LAD-Automotive-Innovations/UA4EFI_ECU/DC_MOTOR_0.1.kicad_sch

## KiCad design DC_MOTOR_0.1.kicad_sch (2025-12-19, last stored version)

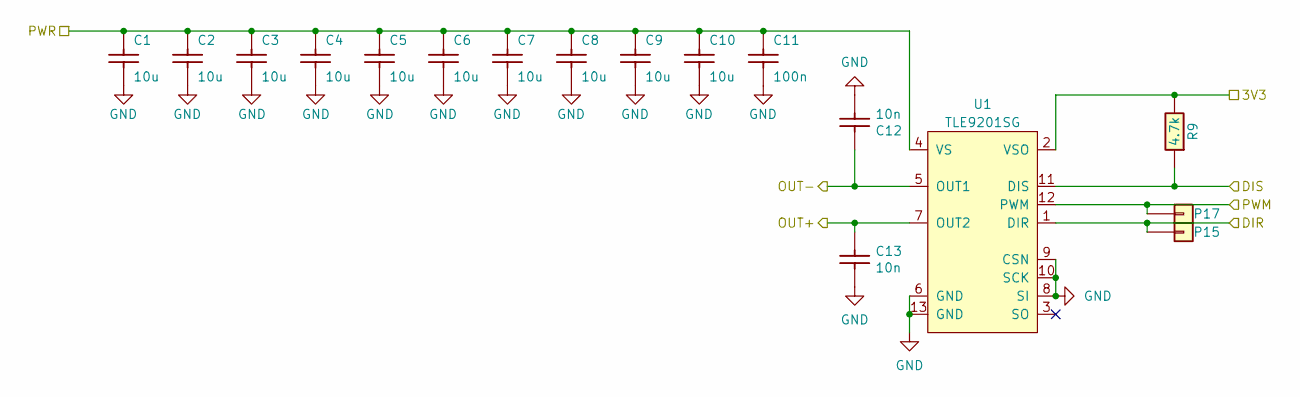
[picture p1: schematic DC_MOTOR_0.1.kicad_sch]

Parts:
C1, C2, C3, C4, C5, C6, C7, C8, C9, C10: 10u; C0805; LCSC C15850
C11: 100n; C0603; LCSC C14663
C12, C13: 10n; C0603; LCSC C57112
P15, P17: Pad; PAD-TH
R9: 4.7k; R0603; LCSC C23162
U1: TLE9201SG; Infineon_PG-DSO-12-11; LCSC C112633

Connections:
3V3: R9.2, U1.2 (VSO)
DIR: P15.1, U1.1 (DIR)
DIS: R9.1, U1.11 (DIS)
GND: C1.1, C2.1, C3.1, C4.1, C5.1, C6.1, C7.1, C8.1, C9.1, C10.1, C11.1, C12.1, C13.1, U1.6 (GND), U1.8 (SI), U1.9 (CSN), U1.10 (SCK), U1.13 (GND)
OUT+: C13.2, U1.7 (OUT2)
OUT-: C12.2, U1.5 (OUT1)
PWM: P17.1, U1.12 (PWM)
PWR: C1.2, C2.2, C3.2, C4.2, C5.2, C6.2, C7.2, C8.2, C9.2, C10.2, C11.2, U1.4 (VS)
