LAD-Automotive-Innovations/UA4EFI_ECU/IGN6.kicad_sch

## KiCad design IGN6.kicad_sch (2025-12-19, last stored version)

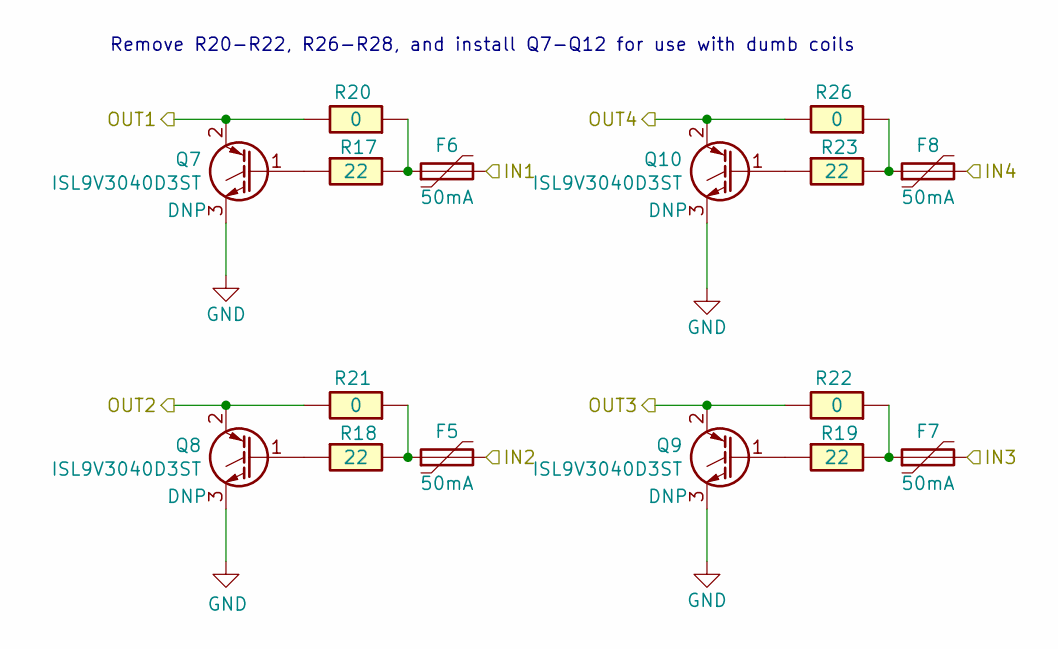
[picture p2: schematic IGN6.kicad_sch]

Parts:
F5, F6, F7, F8: 50mA; Fuse_0603_1608Metric; LCSC C369141
Q7, Q8, Q9, Q10: ISL9V3040D3ST; TO-252-2
R17, R18, R19, R23: 22; R0603; LCSC C23345
R20, R21, R22, R26: 0; R_2512_6332Metric; LCSC C25469

Connections:
GND: Q7.3 (E), Q8.3 (E), Q9.3 (E), Q10.3 (E)
IN1: F6.2
IN2: F5.2
IN3: F7.2
IN4: F8.2
unnamed: F5.1, R18.2, R21.1
unnamed: F6.1, R17.2, R20.1
unnamed: F7.1, R19.2, R22.1
unnamed: F8.1, R23.2, R26.1
unnamed: Q7.1 (G), R17.1
unnamed: Q8.1 (G), R18.1
unnamed: Q9.1 (G), R19.1
unnamed: Q10.1 (G), R23.1
OUT1: Q7.2 (C), R20.2
OUT2: Q8.2 (C), R21.2
OUT3: Q9.2 (C), R22.2
OUT4: Q10.2 (C), R26.2

Notes on the sheet:
Remove R20-R22, R26-R28, and install Q7-Q12 for use with dumb coils
