LAD-Automotive-Innovations/UA4EFI_ECU/INJ6.kicad_sch

## KiCad design INJ6.kicad_sch (2025-12-19, last stored version)

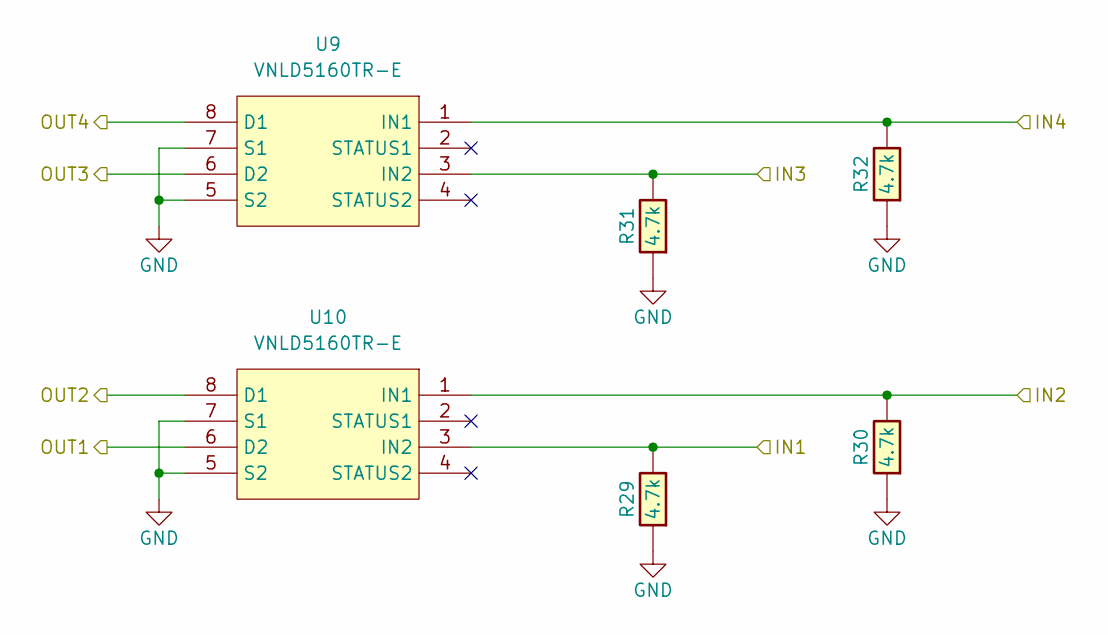
[picture p3: schematic INJ6.kicad_sch]

Parts:
R29, R30, R31, R32: 4.7k; R0603; LCSC C23162
U9, U10: VNLD5160TR-E; SOIC-8_3.9x4.9mm_P1.27mm; LCSC C377942

Connections:
GND: R29.1, R30.1, R31.1, R32.1, U9.5 (S2), U9.7 (S1), U10.5 (S2), U10.7 (S1)
IN1: R29.2, U10.3 (IN2)
IN2: R30.2, U10.1 (IN1)
IN3: R31.2, U9.3 (IN2)
IN4: R32.2, U9.1 (IN1)
OUT1: U10.6 (D2)
OUT2: U10.8 (D1)
OUT3: U9.6 (D2)
OUT4: U9.8 (D1)
