LAD-Automotive-Innovations/UA4EFI_ECU/LS4.kicad_sch

## KiCad design LS4.kicad_sch (2025-12-19, last stored version)

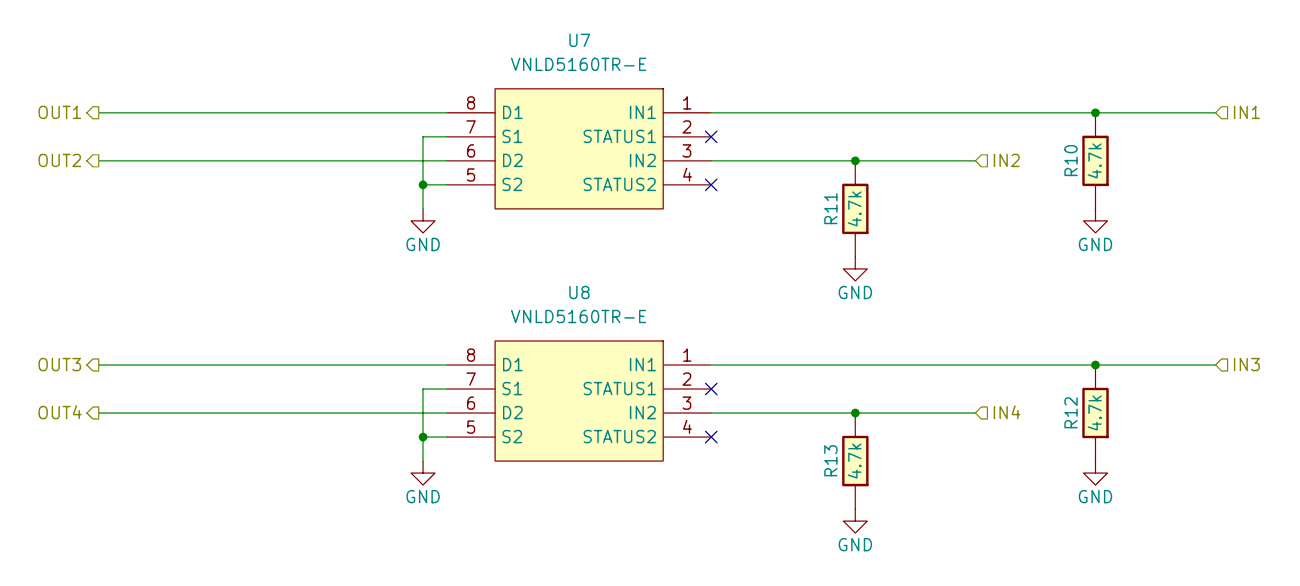
[picture p4: schematic LS4.kicad_sch]

Parts:
R10, R11, R12, R13: 4.7k; R0603; LCSC C23162
U7, U8: VNLD5160TR-E; SOIC-8_3.9x4.9mm_P1.27mm; LCSC C377942

Connections:
GND: R10.1, R11.1, R12.1, R13.1, U7.5 (S2), U7.7 (S1), U8.5 (S2), U8.7 (S1)
IN1: R10.2, U7.1 (IN1)
IN2: R11.2, U7.3 (IN2)
IN3: R12.2, U8.1 (IN1)
IN4: R13.2, U8.3 (IN2)
OUT1: U7.8 (D1)
OUT2: U7.6 (D2)
OUT3: U8.8 (D1)
OUT4: U8.6 (D2)
