LAD-Automotive-Innovations/UA4EFI_ECU/LS_HOT.kicad_sch

## KiCad design LS_HOT.kicad_sch (2025-12-19, last stored version)

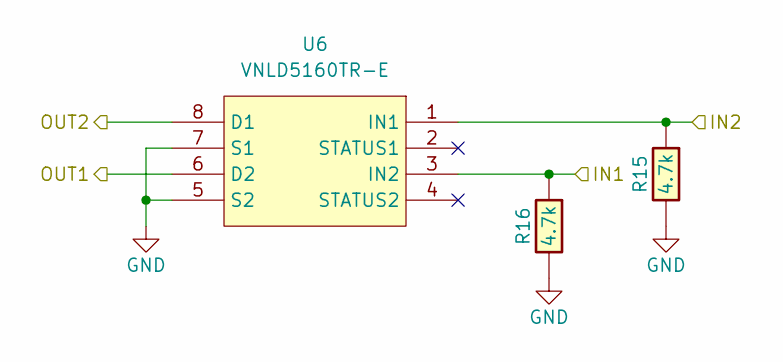
[picture p5: schematic LS_HOT.kicad_sch]

Parts:
R15, R16: 4.7k; R0603; LCSC C23162
U6: VNLD5160TR-E; SOIC-8_3.9x4.9mm_P1.27mm; LCSC C377942

Connections:
GND: R15.2, R16.2, U6.5 (S2), U6.7 (S1)
IN1: R16.1, U6.3 (IN2)
IN2: R15.1, U6.1 (IN1)
OUT1: U6.6 (D2)
OUT2: U6.8 (D1)
