LAD-Automotive-Innovations/UA4EFI_ECU/MAP.kicad_sch

## KiCad design MAP.kicad_sch (2025-12-19, last stored version)

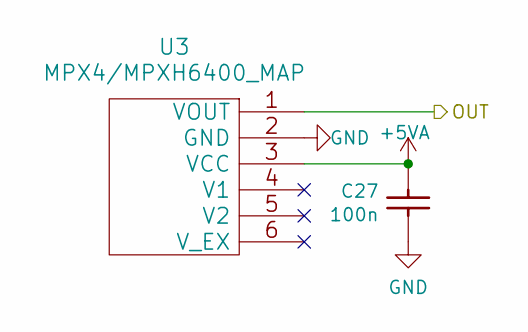
[picture p6: schematic MAP.kicad_sch]

Parts:
C27: 100n; C0603; LCSC C14663
U3: MPX4/MPXH6400_MAP; MPX-4_MAP

Connections:
+5VA: C27.2, U3.3 (VCC)
GND: C27.1, U3.2 (GND)
OUT: U3.1 (VOUT)
