LAD-Automotive-Innovations/UA4EFI_ECU/UA4EFI.kicad_sch

## KiCad design UA4EFI.kicad_sch (2025-12-19, last stored version)

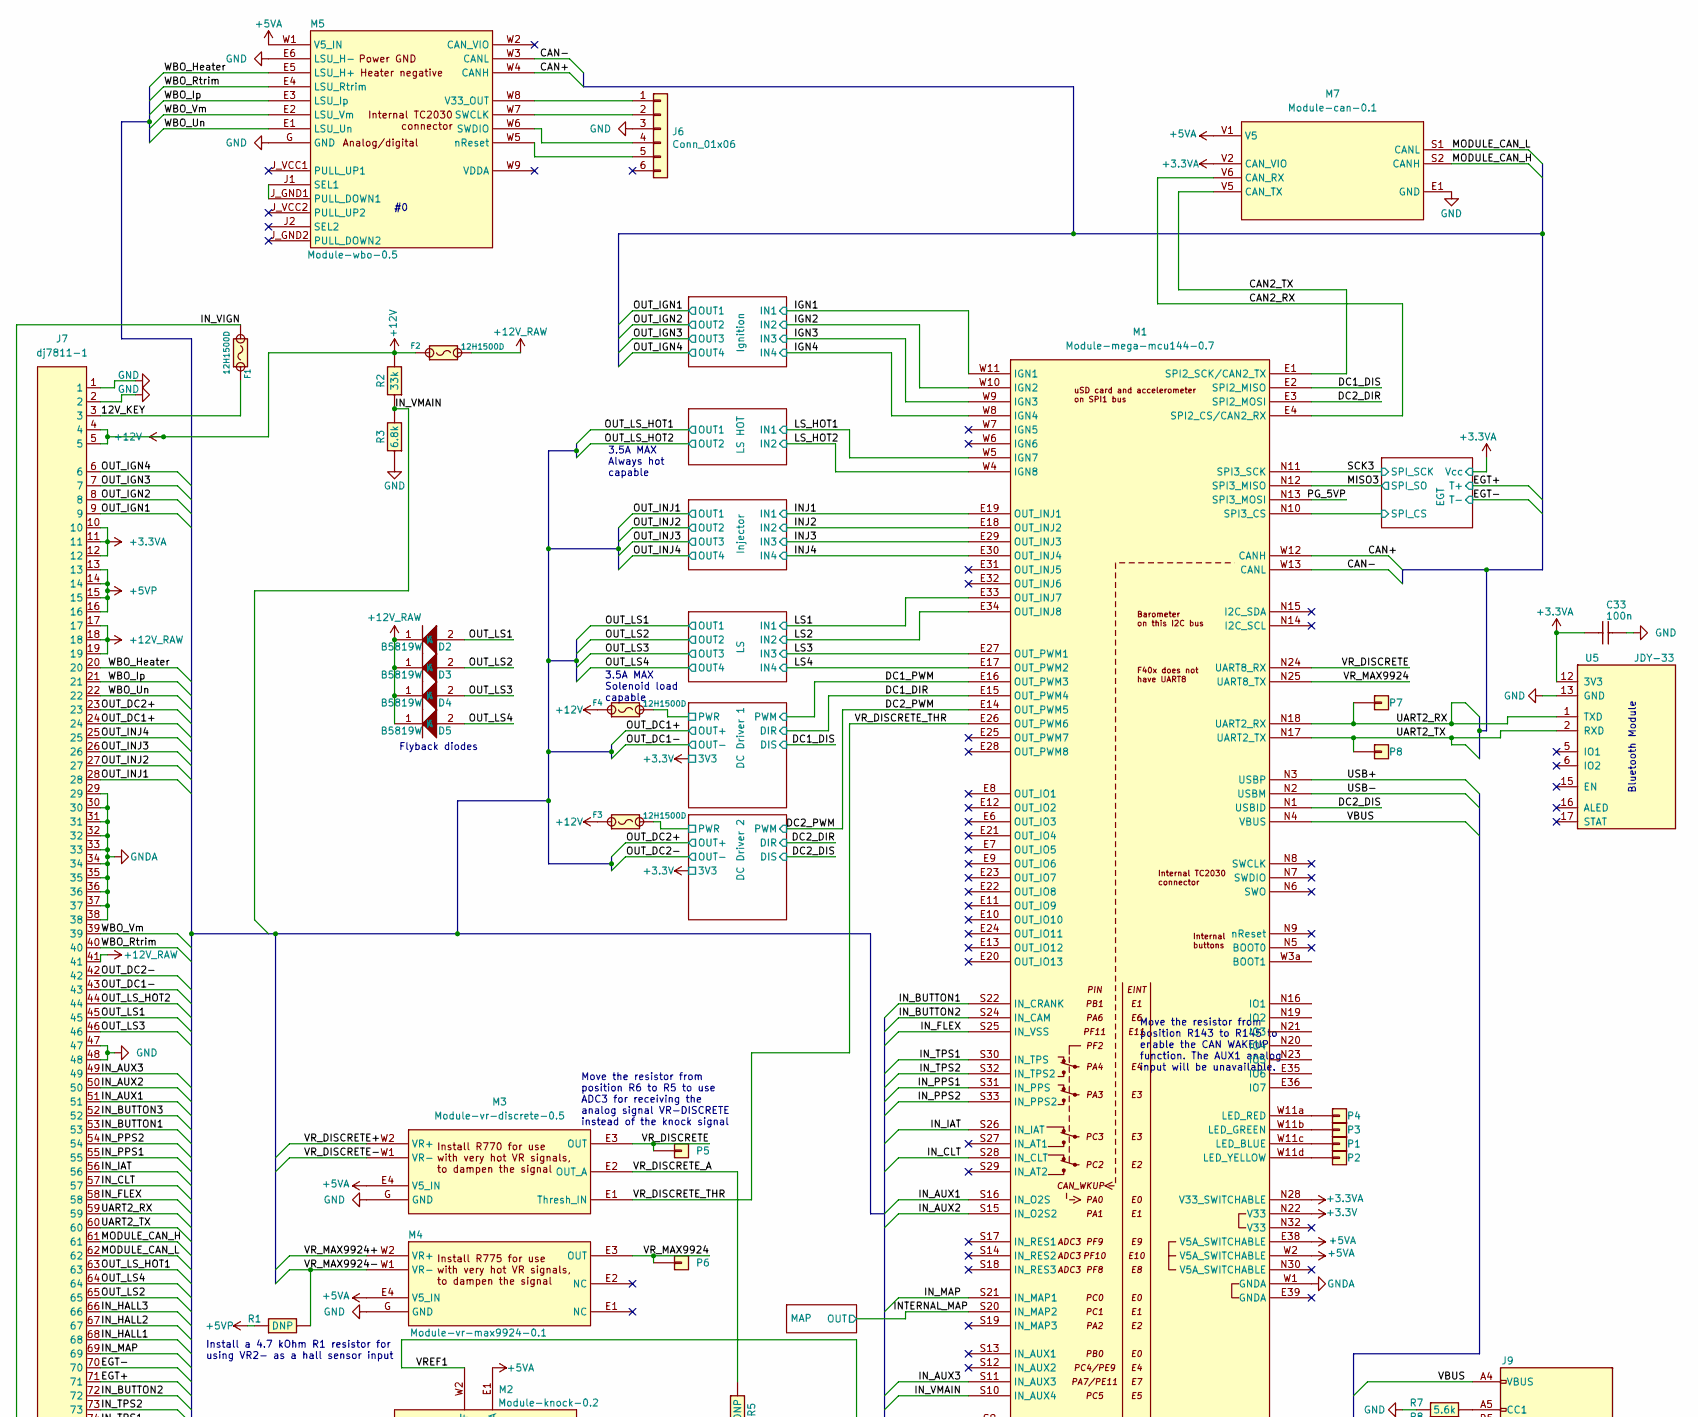
[picture p7: schematic UA4EFI.kicad_sch, part in row 1, column 1]

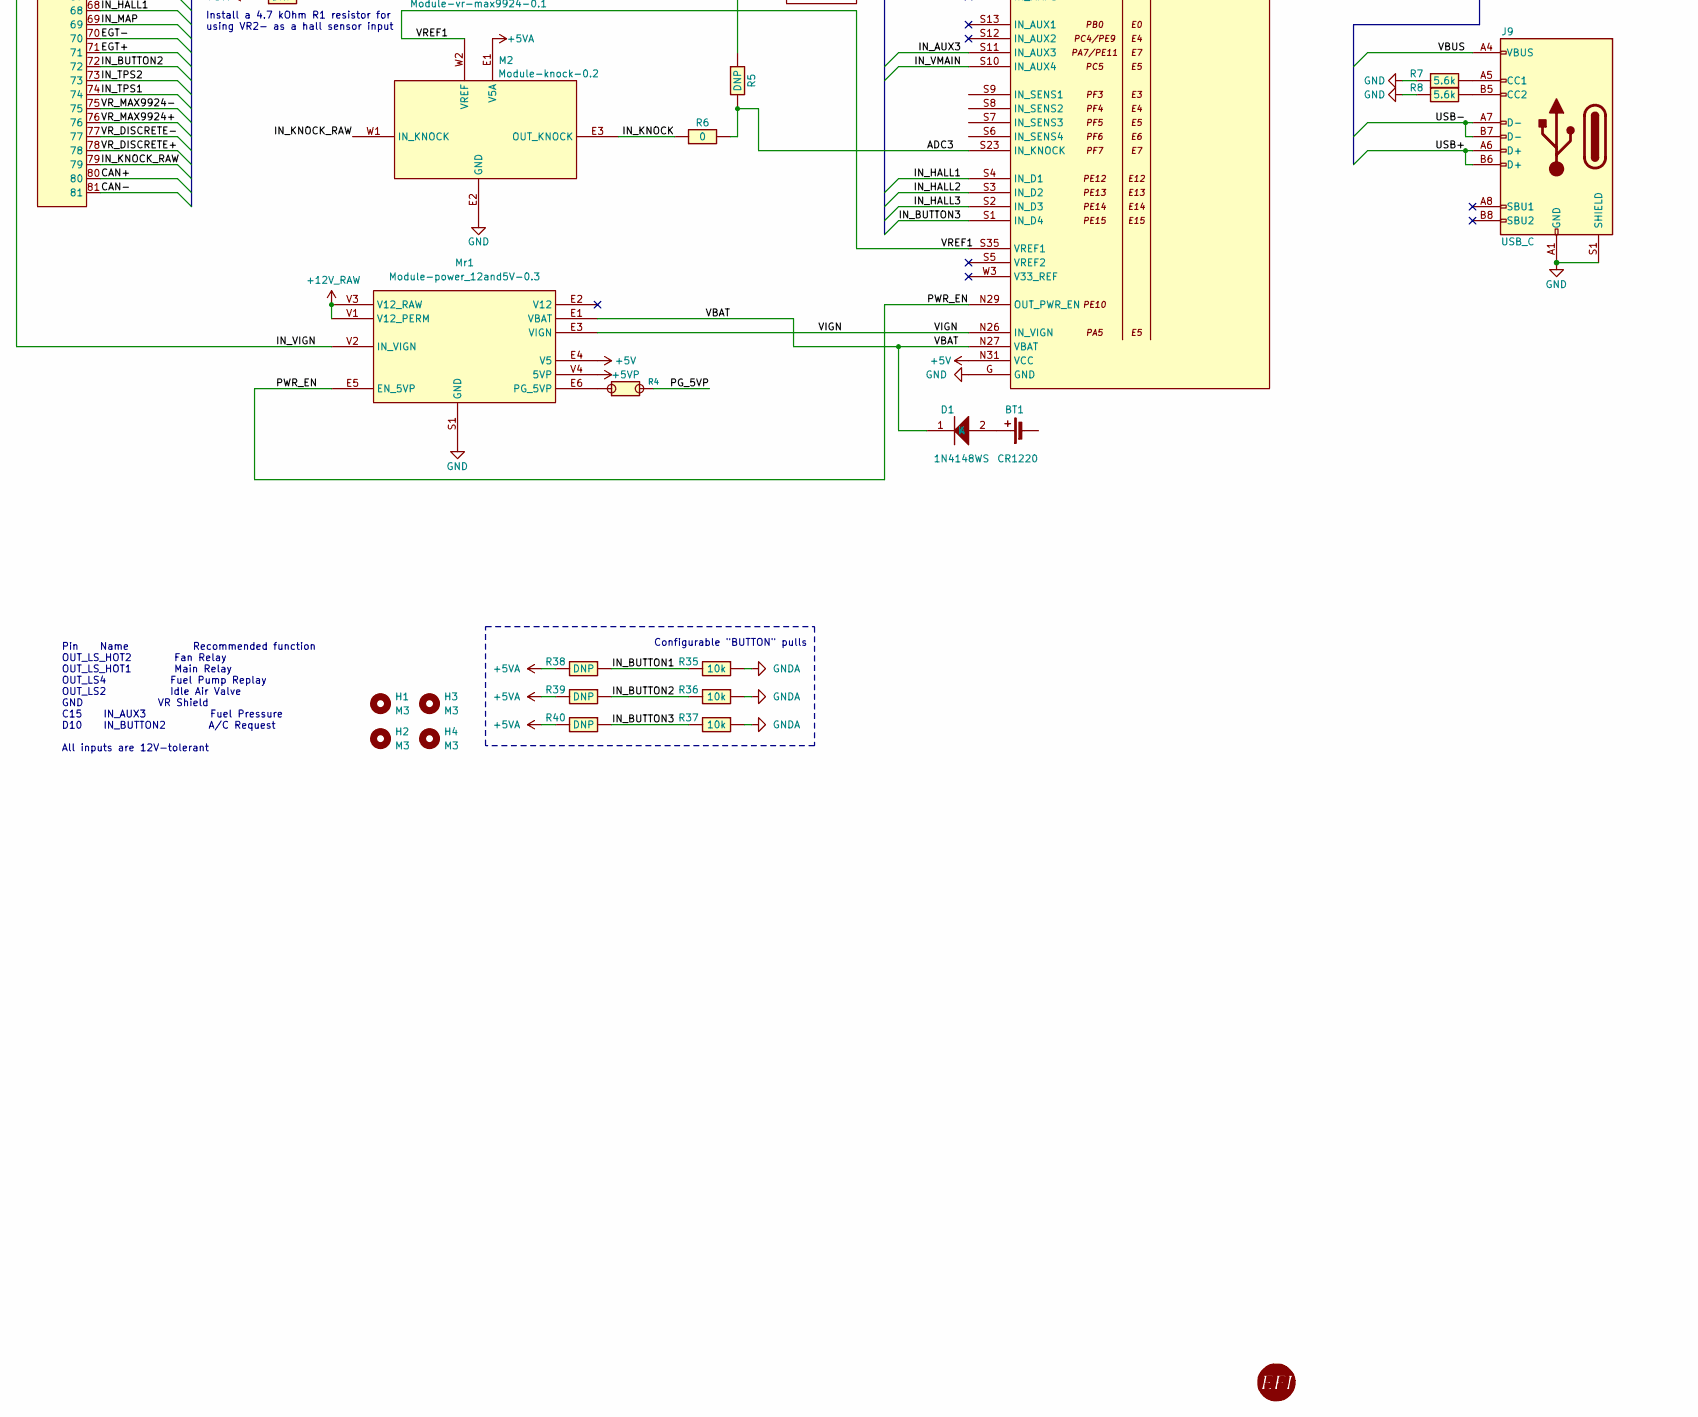
[picture p8: schematic UA4EFI.kicad_sch, part in row 2, column 1]

Parts:
BT1: CR1220; CR1220-2; LCSC C70381
C33: 100n; C0603; LCSC C14663
D1: 1N4148WS; SOD-323; LCSC C2128
D2, D3, D4, D5: B5819W; SOD-123; LCSC C8598
F1, F2, F3, F4: 12H1500D; PAD-1206-PAD; LCSC C182446
G1: RUSEFI_LOGO; rusefi_logo
H1, H2, H3, H4: M3; MountingHole_3.2mm_M3_Pad_Via
J6: Conn_01x06; PinHeader_1x06_P2.54mm_Vertical; LCSC C37208
J7: dj7811-1; LCSC C9900074225
J9: USB_C; LCSC C2927038
M1: Module-mega-mcu144-0.7; mega-mcu144
M2: Module-knock-0.2; knock
M3: Module-vr-discrete-0.5; vr-discrete
M4: Module-vr-max9924-0.1; vr-max9924
M5: Module-wbo-0.5; wbo
M7: Module-can-0.1; can
Mr1: Module-power_12and5V-0.3; power_12and5V
P1, P2, P3, P4, P5, P6, P7, P8: Pad; PAD-TH
R1: 4.7k; R0603
R2: 33k; R0603; LCSC C4216
R3: 6.8k; R0603; LCSC C23212
R4: Jumper-Pad-Pad; PAD-0805-PAD; LCSC C17477
R5: 0; R0603
R6: 0; R0603; LCSC C21189
R7, R8: 5.6k; R0603; LCSC C23189
R35, R36, R37: 10k; R0805; LCSC C17414
R38, R39, R40: DNP; R0805
U5: JDY-33; PARTREV v1.0; LCSC C9900001612

Connections:
12V_KEY: F1.1, J7.3
+3.3V: M1.N22 (V33)
+3.3VA: C33.2, J7.10, J7.11, J7.12, M1.N28 (V33_SWITCHABLE), M7.V2 (CAN_VIO), U5.12 (3V3)
+5V: M1.N31 (VCC), Mr1.E4 (V5)
+5VA: M1.E38 (V5A_SWITCHABLE), M1.W2 (V5A_SWITCHABLE), M2.E1 (V5A), M3.E4 (V5_IN), M4.E4 (V5_IN), M5.W1 (V5_IN), M7.V1 (V5), R38.2, R39.2, R40.2
+5VP: J7.13, J7.14, J7.15, J7.16, Mr1.V4 (5VP), R1.1
+12V: F2.1, F3.1, F4.1, J7.4, J7.5, R2.2
+12V_RAW: D2.1 (K), D3.1 (K), D4.1 (K), D5.1 (K), F2.2, J7.17, J7.18, J7.19, J7.41, Mr1.V1 (V12_PERM), Mr1.V3 (V12_RAW)
ADC3: M1.S23 (IN_KNOCK), R5.2, R6.2
CAN2_RX: M1.E4 (SPI2_CS/CAN2_RX), M7.V6 (CAN_RX)
CAN2_TX: M1.E1 (SPI2_SCK/CAN2_TX), M7.V5 (CAN_TX)
CAN+: J7.80, M1.W12 (CANH), M5.W4 (CANH)
CAN-: J7.81, M1.W13 (CANL), M5.W3 (CANL)
DC1_DIR: M1.E15 (OUT_PWM4)
DC1_DIS: M1.E2 (SPI2_MISO)
DC1_PWM: M1.E16 (OUT_PWM3)
DC2_DIR: M1.E3 (SPI2_MOSI)
DC2_DIS: M1.N1 (USBID)
DC2_PWM: M1.E14 (OUT_PWM5)
EGT+: J7.71
EGT-: J7.70
GND: C33.1, J6.3, J7.1, J7.2, J7.47, J7.48, J9.A1 (GND), J9.A12 (GND), J9.B1 (GND), J9.B12 (GND), J9.S1 (SHIELD), M1.G (GND), M2.E2 (GND), M3.G (GND), M4.G (GND), M5.E6 (LSU_H-), M5.G (GND), M7.E1 (GND), Mr1.S1 (GND), R3.1, R7.1, R8.1, U5.13 (GND)
GNDA: J7.29, J7.30, J7.31, J7.32, J7.33, J7.34, J7.35, J7.36, J7.37, J7.38, M1.W1 (GNDA), R35.1, R36.1, R37.1
IGN1: M1.W11 (IGN1)
IGN2: M1.W10 (IGN2)
IGN3: M1.W9 (IGN3)
IGN4: M1.W8 (IGN4)
INJ1: M1.E19 (OUT_INJ1)
INJ2: M1.E18 (OUT_INJ2)
INJ3: M1.E29 (OUT_INJ3)
INJ4: M1.E30 (OUT_INJ4)
INTERNAL_MAP: M1.S20 (IN_MAP2)
IN_AUX1: J7.51, M1.S16 (IN_O2S)
IN_AUX2: J7.50, M1.S15 (IN_O2S2)
IN_AUX3: J7.49, M1.S11 (IN_AUX3)
IN_BUTTON1: J7.53, M1.S22 (IN_CRANK), R35.2, R38.1
IN_BUTTON2: J7.72, M1.S24 (IN_CAM), R36.2, R39.1
IN_BUTTON3: J7.52, M1.S1 (IN_D4), R37.2, R40.1
IN_CLT: J7.57, M1.S28 (IN_CLT)
IN_FLEX: J7.58, M1.S25 (IN_VSS)
IN_HALL1: J7.68, M1.S4 (IN_D1)
IN_HALL2: J7.67, M1.S3 (IN_D2)
IN_HALL3: J7.66, M1.S2 (IN_D3)
IN_IAT: J7.56, M1.S26 (IN_IAT)
IN_KNOCK: M2.E3 (OUT_KNOCK), R6.1
IN_KNOCK_RAW: J7.79, M2.W1 (IN_KNOCK)
IN_MAP: J7.69, M1.S21 (IN_MAP1)
IN_PPS1: J7.55, M1.S31 (IN_PPS)
IN_PPS2: J7.54, M1.S33 (IN_PPS2)
IN_TPS1: J7.74, M1.S30 (IN_TPS)
IN_TPS2: J7.73, M1.S32 (IN_TPS2)
IN_VIGN: F1.2, Mr1.V2 (IN_VIGN)
IN_VMAIN: M1.S10 (IN_AUX4), R2.1, R3.2
LS1: M1.E33 (OUT_INJ7)
LS2: M1.E34 (OUT_INJ8)
LS3: M1.E27 (OUT_PWM1)
LS4: M1.E17 (OUT_PWM2)
LS_HOT1: M1.W5 (IGN7)
LS_HOT2: M1.W4 (IGN8)
MISO3: M1.N12 (SPI3_MISO)
MODULE_CAN_H: J7.61, M7.S2 (CANH)
MODULE_CAN_L: J7.62, M7.S1 (CANL)
unnamed: BT1.1 (+), D1.2 (A)
unnamed: J6.1, M5.W8 (V33_OUT)
unnamed: J6.2, M5.W7 (SWCLK)
unnamed: J6.4, M5.W6 (SWDIO)
unnamed: J6.5, M5.W5 (nReset)
unnamed: J9.A5 (CC1), R7.2
unnamed: J9.B5 (CC2), R8.2
unnamed: M1.W11a (LED_RED), P4.1
unnamed: M1.W11b (LED_GREEN), P3.1
unnamed: M1.W11c (LED_BLUE), P1.1
unnamed: M1.W11d (LED_YELLOW), P2.1
unnamed: M5.J1 (SEL1), M5.J_GND1 (PULL_DOWN1)
unnamed: Mr1.E6 (PG_5VP), R4.1
OUT_DC1+: J7.24
OUT_DC1-: J7.43
OUT_DC2+: J7.23
OUT_DC2-: J7.42
OUT_IGN1: J7.9
OUT_IGN2: J7.8
OUT_IGN3: J7.7
OUT_IGN4: J7.6
OUT_INJ1: J7.28
OUT_INJ2: J7.27
OUT_INJ3: J7.26
OUT_INJ4: J7.25
OUT_LS1: D2.2 (A), J7.45
OUT_LS2: D3.2 (A), J7.65
OUT_LS3: D4.2 (A), J7.46
OUT_LS4: D5.2 (A), J7.64
OUT_LS_HOT1: J7.63
OUT_LS_HOT2: J7.44
PG_5VP: M1.N13 (SPI3_MOSI), R4.2
PWR: F3.2, F4.2
PWR_EN: M1.N29 (OUT_PWR_EN), Mr1.E5 (EN_5VP)
SCK3: M1.N11 (SPI3_SCK)
SPI_CS: M1.N10 (SPI3_CS)
UART2_RX: J7.59, M1.N18 (UART2_RX), P7.1, U5.1 (TXD)
UART2_TX: J7.60, M1.N17 (UART2_TX), P8.1, U5.2 (RXD)
USB+: J9.A6 (D+), J9.B6 (D+), M1.N3 (USBP)
USB-: J9.A7 (D-), J9.B7 (D-), M1.N2 (USBM)
VBAT: D1.1 (K), M1.N27 (VBAT), Mr1.E1 (VBAT)
VBUS: J9.A4 (VBUS), J9.A9 (VBUS), J9.B4 (VBUS), J9.B9 (VBUS), M1.N4 (VBUS)
VIGN: M1.N26 (IN_VIGN), Mr1.E3 (VIGN)
VREF1: M1.S35 (VREF1), M2.W2 (VREF)
VR_DISCRETE: M1.N24 (UART8_RX), M3.E3 (OUT), P5.1
VR_DISCRETE+: J7.78, M3.W2 (VR+)
VR_DISCRETE-: J7.77, M3.W1 (VR-)
VR_DISCRETE_A: M3.E2 (OUT_A), R5.1
VR_DISCRETE_THR: M1.E26 (OUT_PWM6), M3.E1 (Thresh_IN)
VR_MAX9924: M1.N25 (UART8_TX), M4.E3 (OUT), P6.1
VR_MAX9924+: J7.76, M4.W2 (VR+)
VR_MAX9924-: J7.75, M4.W1 (VR-), R1.2
WBO_Heater: J7.20, M5.E5 (LSU_H+)
WBO_Ip: J7.21, M5.E3 (LSU_Ip)
WBO_Rtrim: J7.40, M5.E4 (LSU_Rtrim)
WBO_Un: J7.22, M5.E1 (LSU_Un)
WBO_Vm: J7.39, M5.E2 (LSU_Vm)

Notes on the sheet:
Move the resistor from position R6 to R5 to use ADC3 for receiving the analog signal VR-DISCRETE instead of the knock signal
Bluetooth Module
Configurable "BUTTON" pulls
Flyback diodes
3.5A MAX Solenoid load capable
Move the resistor from position R143 to R145 to enable the CAN WAKEUP function. The AUX1 analog input will be unavailable.
Pin Name Recommended function OUT_LS_HOT2 Fan Relay OUT_LS_HOT1 Main Relay OUT_LS4 Fuel Pump Replay OUT_LS2 Idle Air Valve GND VR Shield C15 IN_AUX3 Fuel Pressure D10 IN_BUTTON2 A/C Request All inputs are 12V-tolerant
3.5A MAX Always hot capable
Install a 4.7 kOhm R1 resistor for using VR2- as a hall sensor input
