LAD-Automotive-Innovations/UA4EFI_ECU/egt.kicad_sch

## KiCad design egt.kicad_sch (2025-12-19, last stored version)

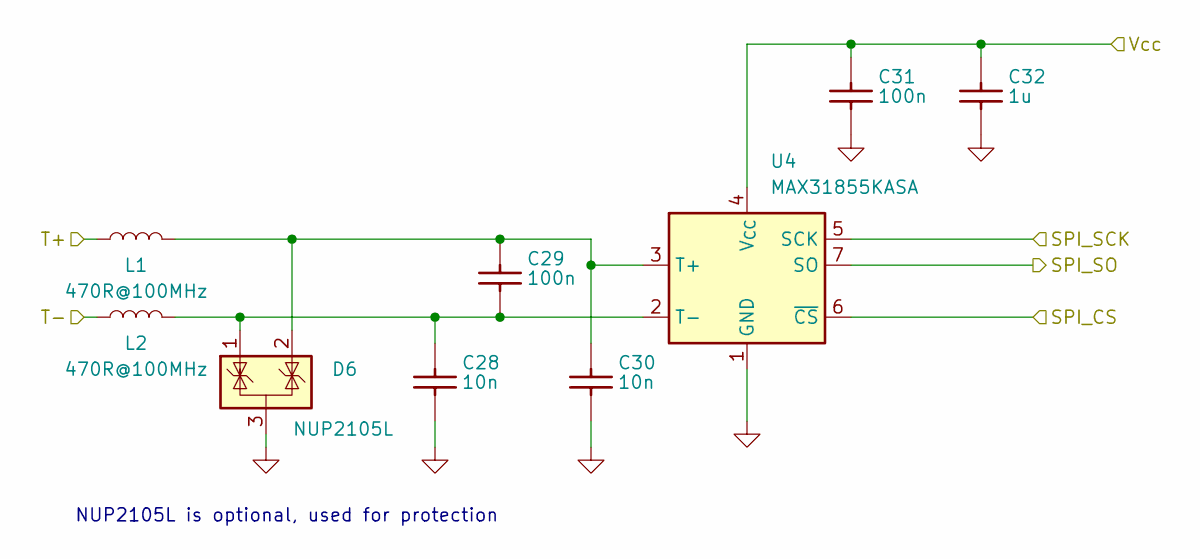
[picture p9: schematic egt.kicad_sch]

Parts:
C28, C30: 10n; C0603; LCSC C57112
C29, C31: 100n; C0603; LCSC C14663
C32: 1u; C0603; LCSC C15849
D6: NUP2105L; SOT-23
L1, L2: 470R@100MHz; L_0603_1608Metric; LCSC C97853
U4: MAX31855KASA; SOIC-8_3.9x4.9mm_P1.27mm; LCSC C52028

Connections:
GND: C28.1, C30.1, C31.1, C32.1, D6.3 (A), U4.1 (GND)
unnamed: C28.2, C29.1, D6.1 (K), L2.2, U4.2 (T-)
unnamed: C29.2, C30.2, D6.2 (K), L1.2, U4.3 (T+)
SPI_CS: U4.6 (~CS)
SPI_SCK: U4.5 (SCK)
SPI_SO: U4.7 (SO)
T+: L1.1
T-: L2.1
Vcc: C31.2, C32.2, U4.4 (V_{CC})

Notes on the sheet:
NUP2105L is optional, used for protection
